emdzej/bimmerz-box/CHANGELOG.md

# Changelog

All notable changes to **bimmerz-box** are documented in this file.

The format follows [Keep a Changelog](https://keepachangelog.com/en/1.1.0/)
and the project adheres to [Semantic Versioning](https://semver.org/spec/v2.0.0.html).

Tags are bare semver (no `v` prefix), e.g. `0.1.0`. The firmware
binary's `esp_app_desc_t::version` field is stamped from `git
describe` at build time, so on a release commit it reads `0.1.0` and
on every other commit it reads the short sha (`-dirty` if the tree
isn't clean).

## [Unreleased]

_(no changes yet)_

## [0.3.1] — 2026-07-09 — 2× file-serve throughput + captive-portal toggle

Two independent improvements found while chasing app-load latency
after the 0.3.0 httpd fix went in.

### Changed — SD + HTTP file-serve path (measured 2-3× faster)

Measured on the WiFi6 devkit against a 293 KB dashx bundle:

| | Before | After | Speedup |
|---|---|---|---|
| 293 KB bundle (avg of 3)  | 523 ms @ 560 KB/s | 230 ms @ 1360 KB/s | **2.4×** |
| 41 KB dashboard JS | 79 ms @ 522 KB/s  | 42 ms @ 984 KB/s | **1.9×** |

Two ingredients, each about half the gain:

- **SD host clock 20 → 40 MHz.** `SDMMC_HOST_DEFAULT()` initialises
  at `SDMMC_FREQ_DEFAULT` (20 MHz, probing-safe). Every modern SD
  card supports `SDMMC_FREQ_HIGHSPEED` (40 MHz) over the 4-bit bus;
  ESP-IDF's `sdmmc_host_do_slot_init` falls back to a slower rate
  automatically if negotiation fails. Change is one line in
  `components/storage/src/storage.c`.
- **HTTP file chunk 4 KB → 32 KB, PSRAM/DMA-capable heap buffer.**
  Previously each `read()` → `httpd_resp_send_chunk` cycle was
  4 KB, causing ~75 syscalls + TCP sends per 293 KB file. Now 10.
  Buffer is `heap_caps_malloc(FILE_CHUNK, MALLOC_CAP_SPIRAM |
  MALLOC_CAP_DMA)` — the SoC lets SDMMC and LWIP DMA straight into
  PSRAM (SOC_SDMMC_PSRAM_DMA_CAPABLE=y, AXI GDMA supports PSRAM),
  no bounce copies. Falls back to internal RAM if the caps request
  fails.

### Added — Captive portal DNS toggle

Some clients (mobile OSes) latch a joining device to a stripped-
down captive-portal browser view that doesn't fully support the
apps' WebSocket flows. Users hitting that can now uncheck **Captive
portal** in Settings and reach the dongle by IP
(`http://172.16.7.1/`) — the DNS hijack is skipped at boot, no
OS-side portal detection triggers.

- Wire: NVS key `captive_dns` (u8, `bimmerz` namespace, `1` =
  hijack DNS to AP IP, `0` = don't start DNS server). Default `1`
  preserves previous behaviour for existing installs.
- API: `/api/config` GET now returns `captive_dns` (bool); POST
  accepts bool or 0/1 number.
- UI: new row in the Wi-Fi AP section of `settings.html`. Takes
  effect after Save & Restart (same as SSID / channel / etc.).

### Backward compatibility

No client-side changes required. `captive_dns` defaults to enabled
so existing deployments behave exactly as before until someone
explicitly unchecks it.

## [0.3.0] — 2026-07-07 — httpd doesn't wedge when switching between apps

Field bug: after opening two or three of ediabasx / inpax / ncsx /
nfsx / dashx in browser tabs and closing them, the dongle's HTTP
server became unresponsive. Curl-probing every endpoint (`/`,
`/rpc/ediabasx`, `/rpc/uart/0`, `/settings/`, `/api/files`) returned
either `Empty reply from server` or `Connection reset by peer` —
TCP layer healthy, HTTPD layer wedged. Required a dongle reboot to
recover.

Three root causes, all in the httpd config:

1. **Accept queue starved** — `HTTPD_DEFAULT_CONFIG()` set
   `max_open_sockets = 7`. Every open browser tab holding a live
   WS burns a slot; keep-alive-warmed admin-UI sockets burn more;
   TIME_WAIT tail (LWIP `TCP_MSL = 60 s`) keeps closed sockets
   occupying LWIP resources; once the pool fills, the httpd worker
   can't accept a fresh socket to handle the next request. Bumped
   to `13`, with `CONFIG_LWIP_MAX_SOCKETS=16` in sdkconfig.defaults
   so the LWIP pool matches.
2. **Stale `holder_fd` in `rpc_uart` / `rpc_can`** — both track a
   single-holder-per-index arbitration. Before this release the
   holder was only cleared on an explicit `uart.close` / `can.close`
   from the client. A browser tab that navigated away without
   sending it left the slot pinned to a now-dead fd; subsequent
   `exclusive: true` opens (nfsx directmode / bootmode) failed
   `bus_busy`, and if httpd recycled the numeric fd for a new
   client, ownership silently transferred to a peer that never
   called `open`. Introduced a `close_fn` in `http_static` that
   fires on every socket close and dispatches to
   `rpc_uart_on_socket_close(sockfd)` +
   `rpc_can_on_socket_close(sockfd)`. Each releases any session
   whose `holder_fd` matches the closing socket.
3. **Long keep-alive reap window** — 30 s idle + 6 × 10 s probes =
   up to 90 s before a dead connection freed its slot. Trimmed to
   15 s + 3 × 5 s = 30 s worst-case. Fast enough to keep the pool
   healthy across app-switch flurries, still comfortably above the
   longest legitimately-idle stretch of a K-line job.

### Changed

- **`components/http_static/src/http_static.c`** —
  `cfg.max_open_sockets = 13`, `cfg.close_fn = on_httpd_socket_close`,
  keep-alive trimmed. PRIV_REQUIRES on `rpc_uart` + `rpc_can` so
  the close_fn can call their release hooks.
- **`sdkconfig.defaults`** — `CONFIG_LWIP_MAX_SOCKETS=16`.
- **`components/rpc_uart/*`** — new public
  `rpc_uart_on_socket_close(int sockfd)` that walks every UART
  index and releases sessions whose `holder_fd == sockfd`.
- **`components/rpc_can/*`** — symmetric
  `rpc_can_on_socket_close(int sockfd)`.

### Impact

No client-side changes required. Behaviour improvement is:

- Browser tab close / navigate-away now releases the K-line /
  CAN wire immediately instead of after a `bus_busy` timeout on
  the next `open`.
- App-switching (dashx → ediabasx → nfsx → …) no longer wedges
  the httpd after 3-4 tabs. Verified via manual multi-app cycling
  after reflash.

## [0.2.0] — 2026-07-06

Post-0.1.0 correctness pass on the firmware, plus a full bring-up +
docs pass for the WiFi6 devkit prototype rig.

### Hardware — WiFi6 devkit bring-up

- **Bench-verified pin map** in
  [`boards/waveshare_p4_wifi6.h`](firmware/components/board/include/boards/waveshare_p4_wifi6.h).
  K-line UART1 lands on **GPIO 20 / 21** (matching the L9637D
  datasheet's TxD/RxD pin naming — TxD is the transceiver's *input*,
  driven from the MCU's TX). CAN0 TWAI lands on **GPIO 33 / 32 / 27**
  (TX / RX / STBY-S) with the standard MCU-side naming CAN uses. The
  header comments the CAN-vs-K-line naming asymmetry so the next
  peripheral doesn't repeat the same swap.
- **Loop verified via** the built-in `klineWireTest` RPC on
  `/rpc/ediabasx`: `rxWhenTxHigh=1, rxWhenTxLow=0, loopOk=true`
  against a real L9637D + 12 V bus supply.

### Fixed

Correctness pass over the firmware in response to a post-0.1.0 code
review. Each fix individually links to its CR item number.

- **CAN session close UAF (`rpc_can`, CR #10).** `rx_pump_task` read
  `s->twai` outside `s_lock` and dereferenced it in
  `twai_receive_v2`; a concurrent `can.close` could call
  `twai_driver_uninstall_v2` in the same window, freeing the handle
  mid-receive. Restructured to capture the handle under the lock,
  receive outside, and join the pump task before
  `driver_uninstall` fires.
- **DNS server teardown UAF (`dns_server`, CR #7).** The
  captive-portal task self-deleted via `vTaskDelete(NULL)` while
  `stop_dns_server` `vTaskDelete`'d the same handle and freed the
  struct; in the wrong interleave the task accessed freed memory on
  the way out. Replaced with signal-and-join via an exit semaphore
  plus a 500 ms `SO_RCVTIMEO` so the loop notices shutdown promptly.
- **DNS wildcard entry deref (`dns_server`, CR #5).** The IP
  fallback at `parse_dns_request` indexed `h->entry->ip.addr`
  (always entry 0) instead of `h->entry[i].ip.addr`. Latent — only
  fires when a second wildcard rule is registered.
- **DNS multi-question handling (`dns_server`, CR #6).** The
  per-question loop never advanced `cur_qd_ptr` / `cur_ans_ptr`,
  so `qd_count > 1` would re-parse question 0 and overwrite
  answer 0. Reject upfront — captive-portal clients always send
  exactly one question anyway.
- **Boot resilience (`app_main`, CR #11).** A single transient
  ESP-Hosted SDIO glitch on cold boot used to bootloop the dongle
  because every stage went through `ESP_ERROR_CHECK`. Tiered
  handling now: essentials still panic, network bring-up (C6 link,
  Wi-Fi AP) retries 5× with linear backoff, and auxiliary stages
  (ediabasx VM, JSON-RPC routes, settings UI, OTA register, USB
  host) log-and-continue. Documented in the file header.

### Security

- **Captive-accept ring lock (`http_static`, CR #8).**
  `s_accepted_ips`, `s_accepted_next` and `s_accepted_count` were
  mutated by HTTP workers with no synchronisation. esp_http_server
  is single-threaded today so the race never fires in practice, but
  a later config change (bumped worker count, off-task checks)
  would corrupt the ring. Wrapped with `portMUX_TYPE`.
- **Reject `%` in app/dashboard paths (`http_static`, CR #12).**
  `uri_is_safe()` did substring checks for `/../` etc. — correct
  only as long as esp_http_server doesn't URL-decode `req->uri`
  before the handler sees it. Reject any `%` outright so the
  substring scan stays honest under future IDF changes. App and
  dashboard URIs never contain `%` literals in practice.

### Documentation

- **New WiFi6 prototype rig guide** at
  [`docs/wifi6-prototype.md`](docs/wifi6-prototype.md) — ASCII setup
  diagram (WiFi6 devkit + fused +12 V → 5 V buck + L9637D + TJA1051 +
  OBD-II socket), per-pin wiring tables, and chassis-specific K-line
  pin-7-vs-pin-8 routing (solder-jumper or SPDT-switch, with the
  pin-8 back-feed hazard called out).
- **New DIY path on the site** for the WiFi6 devkit
  ([`site/docs/products/diy-wifi6.md`](site/docs/products/diy-wifi6.md))
  with nav + sidebar entries in `.vitepress/config.ts`. The existing
  "DIY — from modules" page is retitled "DIY — Module DEV-KIT" and
  cross-linked; the DIY hub table grows from two paths to three.
- **New "Flash prebuilt binaries (from GitHub releases)" section** in
  the top-level [`README.md`](README.md) — `esptool`-based
  instructions for the WiFi6 board (`bootloader-*`, `partition-table-*`,
  `ota_data_initial-*`, `bimmerz_box-*.bin` from any release), plus a
  shorter `@flasher_args.json` invocation.
- **SD-card path alignment across all docs and firmware comments.**
  The firmware serves sibling apps out of `/sdcard/apps/<slug>/` and
  the root-namespace dashboard out of `/sdcard/sys/dashboard/`
  (`APPS_ROOT` / `SYS_ROOT` / `HUB_APP` in
  `firmware/components/http_static/src/http_static.c`); docs and code
  comments that still said `/sdcard/web/…` are reconciled. Touched
  `docs/api.md`, `docs/firmware.md`, `dashboard/README.md`,
  `site/docs/guide/{apps,index}.md`, `site/docs/products/diy.md`, and
  the `http_static` header + source comments.
- **New "Getting the apps onto the SD card" section** in the site
  user guide ([`site/docs/guide/apps.md`](site/docs/guide/apps.md))
  with a per-slug table pointing users at each sibling repo
  (`ediabasx`, `inpax`, `ncsx`, `nfsx`, `tunex`) and the matching
  `/sdcard/apps/<slug>/` deploy target. Build steps live in each
  repo's README — the box docs link out rather than duplicate them.

### Deferred (not in this release)

- **`transport_kline` static state under a mutex (CR #9).** The
  global `s_session` / `s_last_response_ms` would race the moment
  VM work moves off the httpd worker thread. Fix belongs together
  with the dedicated-VM-task migration documented in
  [`docs/firmware.md`](docs/firmware.md) §17 — same threading-model
  change, lands in the same commit series.

## [0.1.0] — 2026-06-15

Initial public release. The Waveshare ESP32-P4 Module DEV-KIT runs
the full diagnostic stack end-to-end against real K-line and CAN
ECUs; the WiFi6 Devkit variant has a board overlay ready for when
hardware lands; the custom dongle PCB is in schematic-capture phase.

### Hardware

- KiCad project for the custom dongle PCB under [`hardware/`](hardware/)
  with the `Various.pretty` footprint library.
- Three target board variants supported by the firmware:
  - [Waveshare ESP32-P4 Module DEV-KIT](https://docs.waveshare.com/ESP32-P4-Module-DEV-KIT)
    (phase 1, bench) — SoM + carrier with onboard C6, SD, Ethernet PHY.
  - [Waveshare ESP32-P4-WiFi6 Devkit](https://docs.waveshare.com/ESP32-P4-WIFI6)
    (phase 2) — single-board variant with same SDIO + SD pinmap, no
    Ethernet PHY.
  - Custom Bimmerz Box dongle PCB (phase 3, fab pending).

### Firmware

- ESP-IDF v5.4.4 project targeting ESP32-P4 with ESP32-C6 as a
  Wi-Fi+BLE co-processor via ESP-Hosted over SDIO Slot 1 (4-bit, 40 MHz).
- Pulls [`ediabasx-embedded`](https://github.com/emdzej/ediabasx-embedded)
  `0.1.0` as a sibling-repo path dependency — full BMW BEST/2
  interpreter + Ediabas wrapper.
- **JSON-RPC 2.0 over WebSocket** at:
  - `/rpc/ediabasx` — diagnostic engine. Wire-compatible with the TS
    server in `~/Projects/my/ediabasx/`, including:
    - CP1252 ↔ UTF-8 transcoding both inbound (args back to the SGBD)
      and outbound (results to the browser), with same-value codepoint
      mapping for undefined CP1252 slots so bytes like `0x81` (the
      `C_FA_LESEN` loop-3 counter) survive round-tripping.
    - `apiJobData` binary-payload channel (`params: [..., {binary:
      "<base64>"}]`) decoded into the VM's binary buffer.
  - `/rpc/uart/<idx>` — raw UART bridge for FTDI-style passthrough.
  - `/rpc/can/<idx>` — TWAI/CAN frame pipe (channels `0` and `1`).
- **Settings UI** at `/settings/` (in-flash, embedded HTML):
  - System status (`/api/info`) — firmware version, chip ID via the
    C6's actual SoftAP MAC, uptime, free heap.
  - Wi-Fi access-point config (SSID / password / channel / AP IP).
  - Ethernet config (off / DHCP / static).
  - SD-card file browser with breadcrumb navigation, upload, recursive
    delete, mkdir.
  - **Firmware OTA** — file picker + XHR-driven progress bar; streams
    `.bin` to `POST /settings/ota/firmware`, validates the ESP image
    header on the first chunk, flips the OTA partition, reboots.
  - **Upload & extract zip** — browser-side decompression via embedded
    `fflate.min.js` so bulk uploads (dashboard build, SGBD packs) land
    in one click.
- **OTA with rollback** (`ota_manager`). After a successful flash, the
  new image boots `PENDING_VERIFY`. A 60 s `esp_timer` grace window
  marks it valid only if the device stays up. Any panic / WDT reset
  inside the window triggers the bootloader to revert to the previous
  slot — bad uploads can't brick the device without USB-JTAG.
- **Dual 7 MB OTA partitions** + dedicated 1 MB `c6_fw` slot for the
  future C6 firmware OTA channel.
- **Captive portal** on first connect — DNS server hijacks every
  lookup to `172.16.7.1`, welcome screen with manual-dismiss UX.
- **File API** (`/api/files`, `/api/files/upload`, `/api/files/raw`,
  `/api/files/mkdir`) backed by FATFS on the SD card. Recursive delete
  for non-empty directories (e.g. `System Volume Information` from
  Windows mounts).
- **SD layout** split into `/sdcard/sys/` (dashboard), `/sdcard/apps/`
  (auto-discovered SPAs), `/sdcard/data/` (DATEN-disk SGBDs).

### Dashboard

- Svelte 5 launcher served at `/` from `/sdcard/sys/dashboard/`.
- Auto-discovers apps from `/sdcard/apps/` via `/api/files`; each app
  exposes a `manifest.json` for tile metadata.
- Splits tile name into stem + accent for the BMW M-tricolour styling
  (default: trailing `X` is the accent; manifest can override).
- Gear icon in the header → `/settings/`.
- BMW M-tricolour palette + 3-band M stripe to match `bimmerz.app`.

### Site (box.bimmerz.app)

- VitePress source under [`site/`](site/), published by
  `.github/workflows/site-deploy.yml`.
- Hero, quickstart, connect / firmware / troubleshooting / apps user
  guides, DIY paths (modules + custom PCB), product pages.
- E46 CAN-on-OBD-II tap-from-IKE wiring note (Cluster `X11175` →
  OBD-II `X19527`, pins 9/10 → 6/14) with the topology + termination
  caveat, plus a parts list (BMW p/n `61138364566` / TE/AMP
  `0-1393431-1` wire taps).

### Continuous integration

- **`firmware-build.yml`** — matrix build on
  `waveshare_p4_module_dev_kit` × `waveshare_p4_wifi6` × `dongle`,
  ESP-IDF v5.4.4. Per-board, version-stamped `.bin` artefacts uploaded
  on every push / PR. On a GitHub Release `published`, the artefacts
  are attached to the release. Sibling `ediabasx-embedded` pinned to
  `0.1.0`, overridable per-run via `workflow_dispatch` input.
- **`site-deploy.yml`** — builds the VitePress site and publishes to
  GitHub Pages.

### Documentation

- [`README.md`](README.md) at the repo root: what's inside, repo
  layout, firmware + dashboard build instructions, OTA / SD-content
  update paths, status callout, sibling-repo links.
- [`docs/firmware.md`](docs/firmware.md) — firmware architecture
  (boot sequence, task model, memory layout, partition table, network
  surface, JSON-RPC server, ediabasx integration, OBD HAL, transport
  components, OTA channels, build configuration, plus the §17 future
  plan for the dedicated-VM-task migration).
- [`docs/hardware.md`](docs/hardware.md) — hardware spec for the
  custom PCB.
- [`docs/api.md`](docs/api.md) — full JSON-RPC method reference.
- [`docs/dev-board-pinout.md`](docs/dev-board-pinout.md) — every GPIO
  the firmware uses on the Module DEV-KIT, with strapping-pin
  warnings + cross-reference to the WiFi6 + dongle variants.

### Known limitations

Documented in-line so callers can decide whether 0.1.0 fits their
threat model and use case. None are blockers for hobby / personal
diagnostic work; all are tracked for follow-up.

- **No authentication on `/settings/*` or `/api/*`.** Anyone on the
  AP can flash firmware, wipe NVS, or read/write the SD card. Treat
  AP Wi-Fi access as physical access until a credential gate lands.
  See [`docs/firmware.md`](docs/firmware.md) §11.2.
- **No OTA image signature verification.** `esp_ota_write` validates
  the ESP image checksum but not provenance. Mitigation path is
  Secure Boot v2 + signed apps; pre-condition is settling on a key
  escrow story.
- **No cooperative break / cancel** for in-flight diagnostic jobs.
  WS disconnect mid-`C_FA_LESEN` lets the VM run the job to
  completion (no leak, just wasted work). Upstream gap in
  ediabasx-embedded; tracked there.
- **VM runs inline on the httpd worker thread.** Both cores are
  available and FreeRTOS is SMP, but the documented dedicated-VM-task
  scheme isn't yet implemented — long jobs block other RPCs.
  Migration plan in [`docs/firmware.md`](docs/firmware.md) §17.
- **C6 firmware OTA** and **asset-bundle OTA** are not yet
  implemented. Partition layout reserves space; today the C6 firmware
  comes preflashed on the Waveshare board, and asset updates are
  per-file via the file API.

### Licensing

- [PolyForm Noncommercial 1.0.0](LICENSE) — free for personal,
  research, hobby use. Commercial use requires a separate licence.
- `.github/FUNDING.yml` — GitHub Sponsors + Buy Me a Coffee.

[Unreleased]: https://github.com/emdzej/bimmerz-box/compare/0.2.0...HEAD
[0.2.0]: https://github.com/emdzej/bimmerz-box/compare/0.1.0...0.2.0
[0.1.0]: https://github.com/emdzej/bimmerz-box/releases/tag/0.1.0
