emdzej/bimmerz-box/(commit log)

2026-06-09 Initial bimmerz-box firmware + dashboard
    ESP32-P4 + ESP32-C6 OBD diagnostic dongle running the ediabasx VM and
    hosting a web dashboard + sibling apps from SD. Single HTTP server on
    port 80 fans out:
    - / → dashboard SPA (svelte 5, from /sdcard/web/dashboard/)
    - /<app>/ → other web apps (inpax, ediabasx, nfsx, ncsx, tunex)
    - /data/ → read-only SD data namespace (SGBDs etc.)
    - /admin/ → embedded admin UI (file browser, system settings)
    - /rpc/ediabasx → JSON-RPC 2.0 over WebSocket to the ediabasx server
    - /welcome → captive-portal welcome page (embedded in flash)
    - /captive/accept → marks client IP "online" so OS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
    [partitions.csv]
2026-06-09 welcome: switch to manual-dismiss UX
    The auto-open-dashboard flow didn't work — the captive WebView opens the
    target inside the sheet instead of handing off to Safari, and the OS
    never dismisses Cancel until it reclassifies the network as online.
    New flow: display the dongle URL prominently, give the user a single OK
    button that flags the client as accepted, then show clear instructions
    to tap Cancel (which on modern iOS just dismisses the sheet, doesn't
    disconnect WiFi) and open the URL in their own browser.
    Also nudges iOS by navigating the WebView to captive.apple.com after
    acceptance — our DNS hijack returns the Success body and iOS may flip
    Cancel → Done. Best-effort; on platfor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
2026-06-10 Add /rpc/uart and /rpc/can WebSocket pipes
    Two sibling JSON-RPC 2.0 endpoints for apps that need direct UART or CAN
    access without going through the ediabasx VM:
    /rpc/uart/<n> — generic UART pipe; /0 is the K-line
    /rpc/can/<n> — generic CAN frame pipe; /0 + /1 reserved for the
    dongle's two TJA1051T transceivers
    Both expose the same shape: open / configure / close lifecycle, base64
    binary payloads, streamed rx via JSON-RPC notifications, and a lock
    model that supports both exclusive (returns bus_busy) and cooperative
    (prior holder gets a *.revoked notification) acquisition.
    UART methods: uart.open / configure / write / transact / slowInit /
    fastInit / close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
2026-06-10 Add hardware/ — KiCad project for the custom dongle PCB
    Initial schematic capture for the dongle PCB based on the Waveshare
    ESP32-P4 Module (the SoM that bundles the SoC + 32MB octal PSRAM +
    flash + crystal + antenna + RF shield with pre-cert). GPIOs picked to
    match what the Waveshare ESP32-P4-Module DEV-KIT exposes, so the
    firmware can prove out drivers on the dev board before the dongle PCB
    is back from fab.
    Gitignore drops KiCad's per-user .prl, auto-backups, and any future
    gerber outputs.
    [BimmerzBox.kicad_pcb, BimmerzBox.kicad_sch]
2026-06-12 Add API reference + dev-board pinout docs
    docs/api.md — comprehensive reference for every endpoint the dongle
    exposes: HTTP (static apps, /data namespace, captive helpers), admin
    /api/* (info, config, restart, factory-reset, file browser), all 28
    methods on /rpc/ediabasx, the /rpc/uart/<n> and /rpc/can/<n>
    JSON-RPC surfaces (including the streaming notifications), and the
    full error code table (HTTP, JSON-RPC standard, ediabasx errorCode,
    machine-readable string errors).
    docs/dev-board-pinout.md — every GPIO assigned on the Waveshare
    ESP32-P4 Module DEV-KIT, grouped by subsystem (C6 link, SD, Ethernet,
    K-line), plus a free-pin table flagging strap pins and USB-JTAG so
    bench tinkering do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
2026-06-12 Add box.bimmerz.app product site
    VitePress site under site/ — published at box.bimmerz.app via
    GitHub Actions on every push that touches site/**. Mirrors the
    parent bimmerz.app conventions: M-tricolour palette, top-of-page
    M-stripe, pnpm, local search.
    Pages:
    index — hero + 6 features + how-it-works summary
    quickstart — 5-step plug-and-go
    guide/ — overview, connect-a-device, using the apps,
    firmware updates, troubleshooting
    products/ — DIY vs ready-to-ship compare, full DIY build
    guide (BOM, parts, steps), pre-launch waitlist
    page for assembled units
    Deploy workflow:
    .github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
2026-06-12 hardware: schematic capture + custom footprint library
    Bulks out the BimmerzBox.kicad_sch with the actual schematic capture
    work — power tree (12 V → 3.3 V), Waveshare ESP32-P4 Module
    connections, K-line front-end (L9637D + TMUX1208), dual CAN
    (TJA1051T ×2), USB-C, SD socket, status LEDs.
    Adds a project-local KiCad footprint library (hardware/Various.pretty)
    with:
    - L9637D — BMW-grade K-line transceiver
    - COMTECH_C-OBD-II-16M — board-mount 16-pin OBD-II receptacle
    - Untitled.kicad_mod — WIP footprint, to be named
    fp-lib-table wires the Various library into the project so
    fab-output passes resolve cleanly.
    [BimmerzBox.kicad_sch]
2026-06-12 site: split DIY into two paths — modules vs custom PCB
    The from-scratch PCB build was the only documented DIY option, but
    plenty of people just want to wire a dev kit to some breakouts and
    get hacking. Splitting the page so both paths are first-class.
    products/diy.md — new DIY hub, side-by-side compare table
    products/diy-modules.md — new draft: Waveshare ESP32-P4 dev kit +
    MikroE ISO 9141 Click + CAN breakouts
    + 12V→5V buck. Wiring table calls out
    the K-line GPIOs from waveshare.h and
    leaves CAN GPIOs as TBD (the dev board
    has them a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
2026-06-12 site: soften status claim — bench + in-car, not MS42-specific
2026-06-12 firmware: ediabasx server hardening for NCSX + long-running jobs
    Three independent fixes that together unblocked NCSX's C_FA_LESEN
    (plus any other job that does many K-line round-trips):
    jsonrpc.c — CP1252 ↔ UTF-8 transcode both directions
    Browser WS text frames MUST be valid UTF-8 (RFC 6455). Result
    strings emitted by SGBDs are Windows-1252, so we add an outbound
    cp1252_to_utf8 transcode in render_result_set. CP1252's five
    undefined slots (0x81 / 0x8D / 0x8F / 0x90 / 0x9D) decode to
    same-value U+00XX codepoints — matches TextDecoder('windows-1252')
    and the C_FA_LESEN loop-3 counter anchor documented in the TS
    ediabasx-core encoding.ts. Mapping them to U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
    [http_static.c, jsonrpc.c]
2026-06-12 rpc_uart/can: fix WS-frame dispatch on wildcard URIs + wire CAN0 + DASHX
    rpc_uart.c / rpc_can.c — session_idx_get/set
    /rpc/uart/<n> and /rpc/can/<n> registered with wildcard URIs and
    is_websocket=true. Handshake worked, but on subsequent WS frames
    esp_http_server invokes the cached sd->ws_handler directly with
    req->uri unpopulated (see httpd_parse.c:755-787) — our handlers
    re-ran parse_*_index(req->uri), got -1, and called
    httpd_resp_send_err HTTP 404 over an already-upgraded WS
    connection. Browser saw the HTTP headers as garbage WS frame
    bytes and closed with "Invalid frame header".
    Fix: parse the index at HANDSHAKE time (req->uri is valid then),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
    [rpc_can.c, rpc_uart.c, waveshare.h]
2026-06-13 jsonrpc: decode {binary: base64} params for CDHapiJobData
    NCSX's coding-read flow (CODIERDATEN_LESEN → C_S_LESEN) passes the
    request packet via the apiJobData binary payload (read by the SGBD's
    pary / parb / parw / parl / parr opcodes). The ediabasx-client wire
    encoding for that channel is an array of `string | {binary: base64}`
    mixed entries — matching the TS server's decodeJobParams shape:
    params: ["0", {binary: "AQIAAAA..."}]
    Our handle_job's array path only knew about plain-number arrays
    (klineProbe-style); the {binary: ...} object form fell through with
    zero binary bytes and SGBDs that called pary returned
    JOB_STATUS=ERROR_NO_BIN_BUFFER.
    handle_job now walks each entry:
    - str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
    [jsonrpc.c]
2026-06-13 admin → settings: rename UI + SD layout sys/+apps/ + zip upload
    - `/admin/` renamed to `/settings/`; admin.html → settings.html; brand
    is now "BimmerzBox Settings". Dashboard gear icon, READMEs, and site
    docs follow the new URL.
    - `/sdcard/web/` split into `/sdcard/sys/` (dashboard) and
    `/sdcard/apps/` (everything else). Dashboard auto-discovers apps
    from `/api/files` + each app's `manifest.json` — no hard-coded list.
    - Settings file browser: recursive delete (rmtree) for non-empty dirs
    (System Volume Information etc.); new "Upload & extract zip" button
    doing in-browser unzip via embedded fflate.min.js (~32 KB) for fast
    bulk uploads.
    - Drop dead `default_app` references i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
2026-06-13 ota_manager: P4 firmware OTA over /settings/ + boot-time rollback
    - Streaming `POST /settings/ota/firmware` endpoint: validates the
    ESP image header in the first chunk, writes to the inactive OTA
    slot via `esp_ota_begin/write/end`, sets boot partition, returns
    JSON `{ok, version, partition, size}`, reboots ~500 ms after the
    response flushes. ~10 s for 1 MB over Wi-Fi.
    - Rollback armed: a fresh image boots `PENDING_VERIFY`; a 60 s
    esp_timer marks it valid only after the device has been up that
    long. Any panic inside the window reverts to the previous slot on
    next reset — no USB-JTAG needed to recover from a bad upload.
    - Settings UI: new "Firmware update" section with a file p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
    [http_static.c]
2026-06-13 admin_ui: read SoftAP MAC from the C6 over esp_hosted
    `esp_read_mac(_, ESP_MAC_WIFI_SOFTAP)` returns zeros on this board —
    the P4 has no Wi-Fi efuse and current ESP-Hosted versions don't set
    the host base MAC. Switch to `esp_wifi_get_mac(WIFI_IF_AP, ...)`,
    which esp_hosted implements as a remote-RPC call to the C6, so
    /api/info's chip_id and the default-SSID derivation now reflect the
    actual radio.
2026-06-13 ci: build firmware for both boards, attach to releases
    - Matrix on `board: [waveshare, dongle]` — each variant layered via
    `sdkconfig.defaults.<board>` over the common defaults.
    - ESP-IDF v5.4.4 in espressif/esp-idf-ci-action; checkout uses
    `fetch-depth: 0` so `git describe` produces a real version string
    in `esp_app_desc_t::version`.
    - Sibling repo `emdzej/ediabasx-embedded` checked out next to
    bimmerz-box so the relative path dep in
    `ediabasx_platform/idf_component.yml` resolves. Pinned to `main`
    via `EDIABASX_EMBEDDED_DEFAULT_REF`; overridable per-run via
    workflow_dispatch input.
    - Per-board artefacts uploaded with version-stamped filenames
    (`bimmerz_box-<board>-<sha|tag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
2026-06-13 ci: pin ediabasx-embedded to 0.1.0
    First tagged release of the sibling repo. Bare semver per its CHANGELOG convention — no `v` prefix. Override per-run via workflow_dispatch input.
2026-06-13 ci: stage board sdkconfig defaults via cat, not -DSDKCONFIG_DEFAULTS
    The action's shell layer strips the single quotes around the
    semicolon-separated value, then bash re-parses the unquoted `;` as a
    command separator — so `sdkconfig.defaults.dongle build` ends up being
    run as a command and the workflow exits with 127.
    Sidestep the quoting entirely: append the board overlay onto
    `sdkconfig.defaults` in a prior step and let IDF pick that file up by
    default. Last-write-wins inside a single file matches the semantics
    of the `-D` form for our case (the overlay only sets board choice).
2026-06-13 Write top-level README, add LICENSE + FUNDING.yml
    - README.md replaces the one-line stub: what it is, what's inside,
    repo layout table, firmware + dashboard build instructions, OTA /
    SD-content update paths, CI overview, status callout (including the
    current no-auth security gap), sibling-repo links. Closes with the
    Right to Repair / Support / License / Disclaimer block from ncsx so
    the whole tool family reads consistently.
    - LICENSE: PolyForm Noncommercial 1.0.0, matching the rest of the
    bimmerz tooling family. Free for personal / research / hobby use;
    commercial use requires a separate licence.
    - .github/FUNDING.yml: GitHub Sponsors + Buy Me a Coffee, matching
    the conventio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
2026-06-13 site: switch license refs to PolyForm Noncommercial
    Three call-outs across the product site still said MIT; the repo now ships PolyForm Noncommercial 1.0.0. Update the home-page feature, the DIY-PCB intro, and its footer to match — with a link to the LICENSE on GitHub for anyone who needs the actual terms.
2026-06-13 board: scaffold waveshare_p4_wifi6 variant, rename waveshare → waveshare_p4_module_dev_kit
    - Add a third board variant: Waveshare ESP32-P4-WiFi6 Devkit
    (https://docs.waveshare.com/ESP32-P4-WIFI6). Same C6-over-SDIO pin
    map and same SD-card slot routing as the Module DEV-KIT — verified
    against the LCD-4.3 reference's IDF examples (05_sdmmc +
    04_wifistation in github.com/waveshareteam/ESP32-P4-WIFI6-Touch-LCD-4.3).
    Ethernet PHY pins zeroed pending schematic confirmation on the base
    WiFi6 board. Buttons / LEDs left TBD.
    - Rename the existing `waveshare` variant to `waveshare_p4_module_dev_kit`
    for symmetry with the new variant name. Touches the board header
    filename, sdkconf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
2026-06-13 docs: reflect all three board variants
    - firmware.md §1.1 — rewrite the three-phase bring-up sequence so
    WiFi6 Devkit gets a phase of its own (between Module DEV-KIT and
    custom PCB) and links to Waveshare's docs.
    - firmware.md §2 — repo-layout listing had a stale `sdkconfig.<board>`
    shorthand from before the rename; fixed to the real
    `sdkconfig.defaults.<variant>` form and added the WiFi6 entry.
    - firmware.md §14 (Build configuration) — Targets now lists all three
    variants with the new Kconfig choice names; Pin-assignments path
    corrected to `firmware/components/board/include/boards/` (was
    pointing at the historical `firmware/main/boards/`); CI matrix line
    updated.
    -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
2026-06-14 docs: record dedicated-VM-task plan as §17
    Future-work section capturing the dual-core migration path: dedicated
    `edxn_vm` task pinned to core 1, fed by a queue from httpd-side RPC
    handlers on core 0. Sequence diagram, job-struct shape, file-by-file
    change list, step-by-step migration order, and the gotchas (no
    cooperative break in the C VM, watchdog risk on long dispatch loops,
    PSRAM stack caveat, hidden httpd-context dependencies in jsonrpc.c).
    Status flagged as deferred — current inline-call model works; we'd
    rather harden RPC correctness across all flows before optimising for
    parallelism. Revisit when long-job blocking becomes a visible UX issue.
2026-06-15 docs: E46 CAN-on-OBD-II tap-from-IKE wiring note
    E46 (and similar E-chassis) don't route D-CAN to the OBD-II socket.
    Document the one-time fix: twisted pair from instrument-cluster
    connector X11175 pins 9/10 (D-CAN-H / D-CAN-L) to OBD-II X19527 pins
    6/14, with the standard caveat about CAN being a daisy-chained bus
    (not a star) and the need for proper termination at the dongle end
    since the TJA1051T/3 in our BOM has no built-in termination.
    Two places:
    * docs/hardware.md §7.1 — reference-doc version, lives next to the
    OBD-II pinout table.
    * site/docs/guide/connect.md — user-facing version under "Cable side
    — OBD-II connection", where E46 owners will hit it when their CAN
    dashbo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
2026-06-15 docs: add E46 CAN wiring parts list — BMW tap 61138364566
    Concrete sourcing notes for the IKE→OBD CAN tap: BMW p/n 61138364566 (TE/AMP 0-1393431-1) sealed wire taps + OBD-II socket crimp pins. Added to both docs/hardware.md §7.1 and the user-facing site/docs/guide/connect.md section with a brief 'don't substitute hardware-store scotchlocks' caveat.
2026-06-15 Add CHANGELOG with 0.1.0 entry, bump site/package.json to 0.1.0
    - CHANGELOG.md (new) at the repo root following Keep a Changelog
    1.1.0. The 0.1.0 entry captures the end-state of the first
    release: hardware (3 board variants), firmware (ediabasx VM,
    JSON-RPC over WS, settings UI, OTA with rollback, file API +
    zip extract, captive portal, new SD layout), dashboard,
    box.bimmerz.app, CI, full documentation, and the four known
    limitations explicitly carried into 0.2 (no auth, no signed OTA,
    no cooperative break, VM not yet on a dedicated task). README
    points at the new CHANGELOG and the bare-semver tag convention.
    - site/package.json: 0.0.0 → 0.1.0 to align with the release.
    d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
2026-06-16 dns_server: fix wildcard-entry deref, qd_count>1, and teardown race
    Three correctness fixes to the captive-portal DNS server, all
    inherited from the Espressif example we'd vendored. Surfaced in code
    review (CR items #5, #6, #7).
    - Wildcard entry deref (#5). The IP-address fallback at the inner
    loop read `h->entry->ip.addr` — always entry[0] — while the rest
    of the loop indexes `entry[i]`. Latent today since only one
    wildcard rule is registered, but it would misroute the moment a
    second rule lands. One-character fix.
    - qd_count > 1 rejection (#6). The per-question loop never advances
    cur_qd_ptr or cur_ans_ptr, so qd_count > 1 would re-parse question
    0 and overwrite answer 0.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
2026-06-16 rpc_can: close UAF between rx_pump_task and driver_uninstall
    CR item #10. The rx pump task was reading `s->twai` outside `s_lock`
    and dereferencing it inside `twai_receive_v2`. A concurrent
    `can.close` ran `driver_uninstall(s)` (which calls
    `twai_driver_uninstall_v2(s->twai); s->twai = NULL`) at the same
    time — classic UAF, would trip the moment a client closed a session
    while frames were arriving.
    Two coordinated changes:
    - rx_pump_task captures `rx_run` and `s->twai` under `s_lock` at the
    top of each iteration, then does the receive with the captured
    handle outside the lock. Holder/server are re-read just before
    sending so a mid-iteration session swap routes to the new
    holder.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
    [rpc_can.c]
2026-06-16 app_main: tiered failure handling, bounded retry on network bring-up
    CR item #11. Every boot stage going through ESP_ERROR_CHECK meant a
    single transient ESP-Hosted SDIO glitch on cold boot guaranteed a
    bootloop. Three-tier policy now, documented in the file header:
    * Essential (panic): log_bus_init, NVS, storage_mount,
    obd_hal_init+IDLE, http_static_start, http_static_install_fallback.
    Nothing downstream works without these; a boot loop here is
    correct because the bootloader's rollback-on-WDT logic kicks in.
    * Network bring-up (bounded retry): c6_host_init, wifi_ap_init. Five
    attempts with linear backoff (0.5/1.0/1.5/2.0 s), then panic if
    the link still won't come up. The retry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
    [app_main.c]
2026-06-16 http_static: lock captive-accept ring, reject `%` in safe-uri check
    Defensive hardening for two CR items.
    * #8 — `s_accepted_ips` / `s_accepted_next` / `s_accepted_count` were
    mutated by HTTP workers with no synchronisation. esp_http_server is
    single-threaded today so the race never fires in practice, but the
    moment anyone bumps worker_count or moves the check onto another
    task it would corrupt the ring. Wrapped with a `portMUX_TYPE`
    spinlock — contention-free now, robust to future config changes.
    Factored the existing "is this IP already in the ring" body into
    `captive_contains_locked` so mark_accepted can do its check + write
    in one critical section (portMUX is non-rec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
2026-06-16 CHANGELOG: record post-0.1.0 correctness fixes under [Unreleased]
    Six bug fixes + one deferred item, traceable back to the code-review
    items they address (CR #5/#6/#7 DNS server, CR #8/#12 http_static,
    CR #10 rpc_can, CR #11 app_main). CR #9 (transport_kline static
    state) deferred to the §17 VM-task migration since it's the same
    threading-model change.
2026-06-25 docs: full OBD-II socket pin breakdown for the back-of-socket crimp
    Extends the existing E46-CAN-tap section with the actual housing
    identity and compatible Micro Timer II contacts (gold + tin
    variants, standard 0.5-1.0 mm^2 and thin 0.2-0.6 mm^2 wire, reel and
    loose-piece SKUs, mapped back to BMW OE numbers where known).
    Housing: TE Connectivity 968915-1 (BMW OE 61138380698). Mates only
    with Micro Timer II - explicit warning about MQS (0.63 mm tab) and
    Micro Timer I incompatibility, since the price-shopping route hits
    those first.
    Standard wires (pin 16 supply, pins 4/5 GND, main signals):
    * Gold: reel 964263-3 / loose 964275-3 (BMW OE 61138364519)
    * Tin: reel 964263-2 / loose 964275-2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
2026-07-06 waveshare_p4_wifi6: bench-verified pinout, docs, and DIY site page
    Pin map (verified on the prototype board via klineWireTest → loopOk=true):
    KLINE_TX = 20 L9637D TxD-in
    KLINE_RX = 21 L9637D RxD-out
    CAN0_TX = 33 TJA1051 TXD
    CAN0_RX = 32 TJA1051 RXD
    CAN0_STBY = 27 TJA1051 S (active-low enable, matching TJA1051T/3)
    K-line labels follow the L9637D datasheet (TxD = transceiver's input,
    comes from the MCU's TX pin) while CAN labels follow the MCU
    perspective. The asymmetry is documented in the header.
    docs/wifi6-prototype.md — new OBD-II wiring rig with ASCII diagram
    (fused +12 V → 5 V buck → WiFi6 devkit VBUS + L9637D + TJA1051 +
    OBD-II socket), pin tables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
2026-07-06 docs: align SD-card paths to firmware source of truth
    The firmware serves sibling web apps out of /sdcard/apps/<slug>/ and
    the root-namespace dashboard hub out of /sdcard/sys/dashboard/
    (APPS_ROOT, SYS_ROOT, HUB_APP in http_static.c). Docs and code
    comments drifted to a stale /sdcard/web/ convention that no longer
    matches what the server actually mounts — reconcile every remaining
    reference.
    Path corrections:
    /sdcard/web/<app>/ → /sdcard/apps/<slug>/
    /sdcard/web/dashboard/ → /sdcard/sys/dashboard/
    /sdcard/web/ → /sdcard/apps/ (or /sdcard/sys/, per context)
    Files touched:
    firmware/components/http_static/{include/http_static.h,src/http_static.c}
    — he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
    [http_static.c, http_static.h]
2026-07-06 release: 0.2.0
    Rename [Unreleased] to [0.2.0] with today's date and add the sections
    covering this release's bring-up + docs work on top of the correctness
    pass that was already staged:
    - Hardware — WiFi6 devkit bench-verified pin map (K-line GPIO 20/21,
    CAN0 GPIO 33/32/27) with the CAN-vs-K-line naming-convention note.
    - Documentation — new docs/wifi6-prototype.md rig guide, new site DIY
    path (products/diy-wifi6.md) with nav updates, new "Flash prebuilt
    binaries" section in README, SD-card path alignment across all docs
    and firmware comments (/sdcard/web/ → /sdcard/apps/ + /sdcard/sys/),
    and a "Getting the apps onto the SD card" section pointing users at
    each sibling repo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
2026-07-06 docs: fix WiFi6 rig power rails — VSYS input + transceiver VIO/Vcc split
    Two corrections against a bench-hardware review:
    1. **DC-DC output goes to VSYS, not VBUS.**
    VBUS on the Waveshare ESP32-P4-WiFi6 devkit is the USB-side 5 V —
    sourced from the USB-C host when a cable is plugged. Feeding the
    buck's output there back-feeds the USB port. VSYS is the board's
    own 5 V system rail into the on-board 3.3 V regulator; that's the
    pin the external 12 → 5 V buck must drive.
    2. **Both transceivers need split-supply wiring.**
    - TJA1051T/3: Vcc = 5 V (bus-side, from VSYS/buck),
    VIO = 3.3 V (logic-side reference for TXD/RXD/S, from the
    board's 3V3 pin). Tying VIO to V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
2026-07-06 docs: specify K-line transceiver as L9637D013TR (SO-8 auto-grade)
    Bill-of-materials-adjacent references to the K-line transceiver now
    call out ST's specific ordering part number — L9637D013TR (L9637D
    in SO-8, automotive-grade, tape-and-reel) — rather than the bare
    family name "L9637D". Also spell out that the MikroE ISO 9141 Click
    IS the L9637D013TR breakout, in the intro sentence and the link
    text on each DIY page (previously just linked as "MikroE product
    page" with the family name in the description).
    Touched:
    README.md, docs/hardware.md (§6.1 K-line front-end + §BOM row),
    docs/wifi6-prototype.md (transceiver-choice bullet),
    site/docs/products/{diy-modules,diy-wifi6}.md (part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
2026-07-06 docs: rewrite WiFi6 setup diagram as separate blocks with inline signals
    The previous ASCII layout tried to route each individual GPIO trace
    from the WiFi6 board down and across to the L9637D / TJA1051 boxes.
    Every character-column shift broke alignment — the vertical bars on
    the "common GND rail" row didn't line up with the corner turns two
    lines below, and readers reported the misalignment made the diagram
    hard to follow.
    Redrew as three cleanly-separated blocks (OBD-II socket, WiFi6
    devkit, transceivers) with each connection stated inline as a
    labeled arrow — no long routing lines that need to align across
    20+ characters. The board block lists its GPIO functions with the
    destination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
2026-07-06 site: call out OBD-II connector as a distinct DIY part
    Both DIY pages had an "OBD-II cable" section but it treated the
    J1962 male connector as an implicit part of a pre-made pigtail. Some
    builders want to source the bare connector separately (e.g. for
    soldering directly into a custom enclosure), and the previous
    wording didn't make that path visible.
    Renamed the section to "OBD-II connector / cable" on both
    diy-wifi6.md and diy-modules.md, and listed two sourcing options:
    1. Pre-made pigtail — J1962 male + bare wires / terminal block.
    2. Bare J1962 male connector (Molex 34825-0160, TE 1-1747844-1,
    or generic clones) for solder-in builds.
    Also spelled out which pins actually need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
2026-07-06 ci(site): bump Node to 24 in site-deploy.yml
    firmware-build.yml doesn't use Node — no change needed there.
    site/package.json engines floor left at ">=20" (VitePress support
    minimum); raising it wouldn't add CI benefit and would exclude LTS
    users.
2026-07-06 docs: document the app manifest.json schema
    The dashboard reads /<slug>/manifest.json from every subdirectory
    under /sdcard/apps/ at load time to render its tile (name, description,
    version, icon, accent styling, requires). Until now the schema lived
    only in dashboard/src/tiles.ts (the AppManifest TypeScript type), so
    sibling-app authors had no way to discover which fields go in the
    manifest without reading dashboard source.
    Adds a documented schema in two places:
    - site/docs/guide/apps.md — "App manifest" section between "Getting
    the apps onto the SD card" and "Loading data files". Full schema
    table + worked example, plus opt-out and custom-accent examples,
    and a discovery-flow re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
2026-07-07 release: 0.3.0 — httpd no longer wedges after switching between apps
    Field bug: opening 2-3 of ediabasx/inpax/ncsx/nfsx/dashx in browser
    tabs, closing them, then trying again — dongle's HTTP server became
    unresponsive across every endpoint (curl-probed `/`, `/rpc/*`,
    `/settings/`, `/api/*` all returned empty-reply / RST while ping
    worked). Required a dongle reboot to recover.
    Three root causes:
    1. `HTTPD_DEFAULT_CONFIG()` → `max_open_sockets = 7`. Every open
    WS-holding tab burns a slot; keep-alive-warmed sockets burn
    more; TIME_WAIT tail (60 s) keeps closed sockets pinned; once
    the pool fills, httpd can't accept another request.
    → `cfg.max_open_sockets = 13` + `CONFIG_L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
    [http_static.c, rpc_can.c, rpc_can.h, rpc_uart.c, rpc_uart.h]
2026-07-09 release: 0.3.1 — 2× file-serve throughput + captive-portal toggle
    Two independent improvements after 0.3.0 landed.
    ## Perf — SD + HTTP file-serve path
    Measured on WiFi6 devkit against a 293 KB dashx bundle:
    before: 523 ms @ 560 KB/s (avg of 3)
    after: 230 ms @ 1360 KB/s (avg of 3, peak 1868 KB/s) → 2.4×
    - SD host clock 20 → 40 MHz. SDMMC_HOST_DEFAULT() ships with
    SDMMC_FREQ_DEFAULT for probing safety; every modern card
    supports SDMMC_FREQ_HIGHSPEED over the 4-bit bus and ESP-IDF
    falls back automatically if negotiation fails.
    - HTTP file chunk 4 KB → 32 KB, heap-allocated in PSRAM with
    DMA caps so SDMMC + LWIP DMA straight into the buffer (no
    bounce copies). Cu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
    [http_static.c, storage.c]
